electrolama/zoe/README.md

# zoe

A PoE powered Zigbee dev kit with RTC for Raspberry Pi.

Details at [electrolama.com/p/zoe](https://electrolama.com/projects/zoe).

zoe is designed by Electrolama / Omer Kilic and licensed under the [Solderpad Hardware License 2.0](https://solderpad.org/licenses/SHL-2.0/).
