electrolama/zoe/Revision C/pi-zigbee-poe-rtc.brd

## EAGLE design Revision C/pi-zigbee-poe-rtc.brd (2020-01-02)

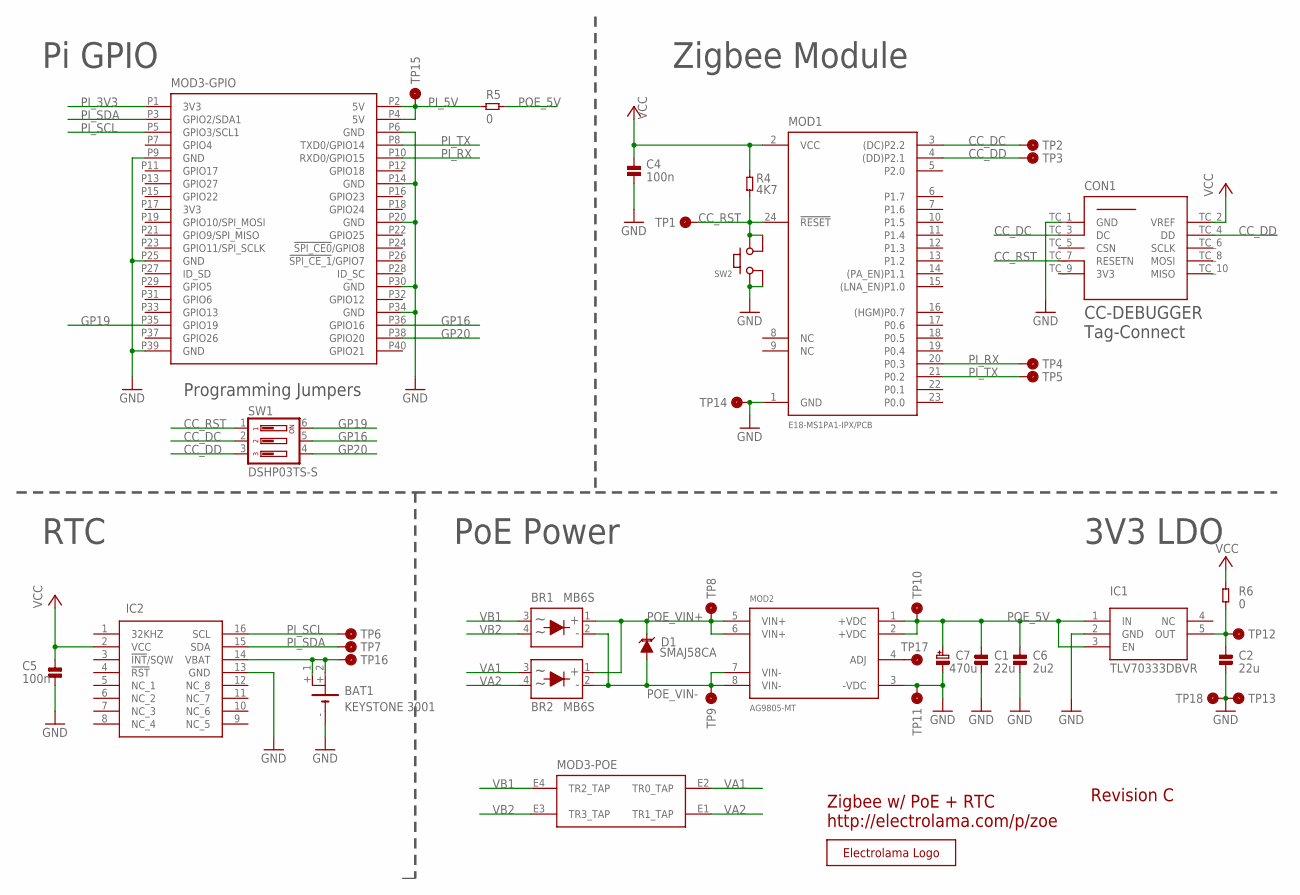
[picture p1: schematic pi-zigbee-poe-rtc.sch]

Parts:
BAT1: KEYSTONE 3001; KEYSTONE_3001
BR1, BR2: MB6S; SOP254P665X270-4N
C1, C2: 22u; _PKG_C_0805
C4, C5: 100n; _PKG_C_0603
C6: 2u2; _PKG_C_0603
C7: 470u; _CAP_ELCO_D8_L10.5
CON1: TC2050-IDC-NL_CC-DEBUGGER; TC2050-IDC-NL
D1: SMAJ58CA; DIOM5126X250N-NOPOL
IC1: TLV70333DBVR; SOT95P280X145-5N
IC2: RTC-DS3231SN#; SOIC127P1032X265-16N
MOD1: E18-MS1PA1-IPX/PCB; EBYTE-E18-MS1PA1
MOD2: AG9805-MT; SILVERTEL_AG9800M
MOD3: RPI-HAT-FULL
R4: 4K7; _PKG_C_0603
R5, R6: 0; TP_DUAL_1206
SW1: DSHP03TS-S
SW2: SPNO-XKB-TS-1187A; XKB-TS-1187A
TP1, TP2, TP3, TP4, TP5, TP6, TP7, TP8, TP9, TP10, TP11, TP12, TP13, TP14, TP15, TP16, TP17: TP; TP_DOT
TP18: TP-HOOK; TP_S2751-46R
U$1: LOGO-ELECTROLAMA; ELECTROLAMA

Connections:
CC_DC: CON1.TC_3 (DC), MOD1.3 ((DC)P2.2), SW1.2, TP2.TP
CC_DD: CON1.TC_4 (DD), MOD1.4 ((DD)P2.1), SW1.3, TP3.TP
CC_RST: CON1.TC_7 (RESETN), MOD1.24 (!RESET), R4.1, SW1.1, SW2.C (2_1), SW2.D (2_2), TP1.TP
GND: BAT1.-, C1.1, C2.1, C4.2, C5.2, C6.2, C7.-, CON1.TC_1 (GND), IC1.2 (GND), IC2.13 (GND), MOD1.1 (GND), MOD2.3 (-VDC), MOD3.P6 (GND), MOD3.P9 (GND), MOD3.P14 (GND), MOD3.P20 (GND), MOD3.P25 (GND), MOD3.P30 (GND), MOD3.P34 (GND), MOD3.P39 (GND), SW2.A (1_1), SW2.B (1_2), TP11.TP, TP13.TP, TP14.TP, TP18.1
GP16: MOD3.P36 (GPIO16), SW1.5
GP19: MOD3.P35 (GPIO19), SW1.6
GP20: MOD3.P38 (GPIO20), SW1.4
LDO_OUT: C2.2, IC1.5 (OUT), R6.1, TP12.TP
unnamed: BAT1.+_1 (+1), BAT1.+_2 (+2), IC2.14 (VBAT), TP16.TP
PI_3V3: MOD3.P1 (3V3)
PI_5V: MOD3.P2 (5V), MOD3.P4 (5V), R5.1, TP15.TP
PI_RX: MOD1.20 (P0.3), MOD3.P10 (RXD0/GPIO15), TP4.TP
PI_SCL: IC2.16 (SCL), MOD3.P5 (GPIO3/SCL1), TP6.TP
PI_SDA: IC2.15 (SDA), MOD3.P3 (GPIO2/SDA1), TP7.TP
PI_TX: MOD1.21 (P0.2), MOD3.P8 (TXD0/GPIO14), TP5.TP
POE_5V: C1.2, C6.1, C7.+, IC1.1 (IN), IC1.3 (EN), MOD2.1 (+VDC), MOD2.2 (+VDC), R5.2, TP10.TP
POE_ADJ: MOD2.4 (ADJ), TP17.TP
POE_VIN+: BR1.1 (+), BR2.1 (+), D1.1 (C), MOD2.5 (VIN+), MOD2.6 (VIN+), TP8.TP
POE_VIN-: BR1.2 (-), BR2.2 (-), D1.2 (A), MOD2.7 (VIN-), MOD2.8 (VIN-), TP9.TP
VA1: BR2.3, MOD3.E2 (TR0_TAP)
VA2: BR2.4, MOD3.E1 (TR1_TAP)
VB1: BR1.3, MOD3.E4 (TR2_TAP)
VB2: BR1.4, MOD3.E3 (TR3_TAP)
VCC: C4.1, C5.1, CON1.TC_2 (VREF), IC2.2 (VCC), MOD1.2 (VCC), R4.2, R6.2

Notes on the sheet:
RTC
Pi GPIO
Zigbee Module
PoE Power
3V3 LDO
Zigbee w/ PoE + RTC http://electrolama.com/p/zoe
Revision C
CC-DEBUGGER Tag-Connect
Programming Jumpers

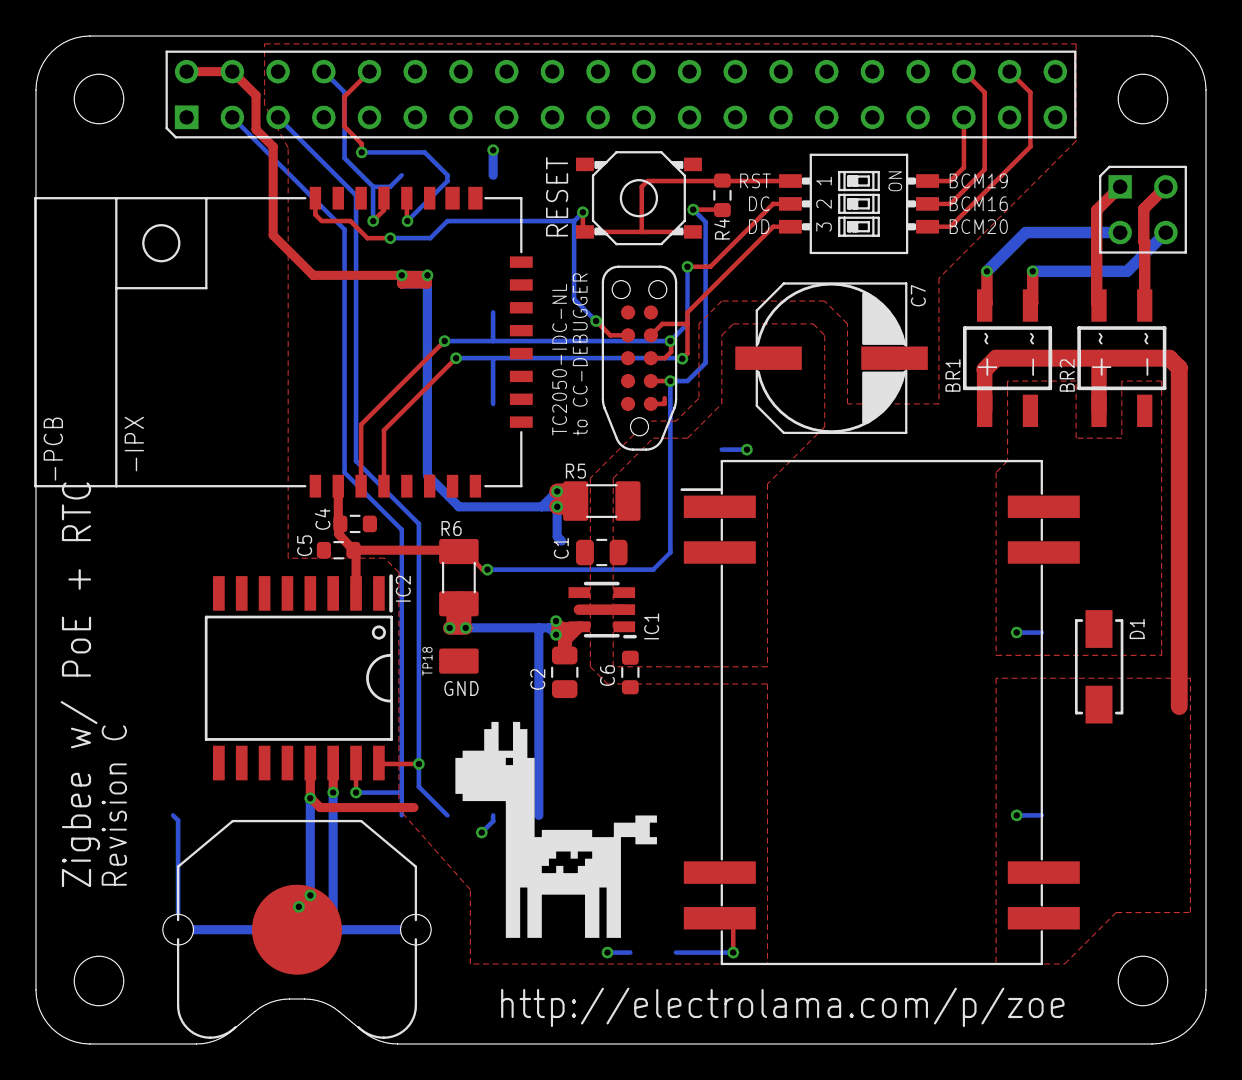
[picture p2: board pi-zigbee-poe-rtc.brd from above]

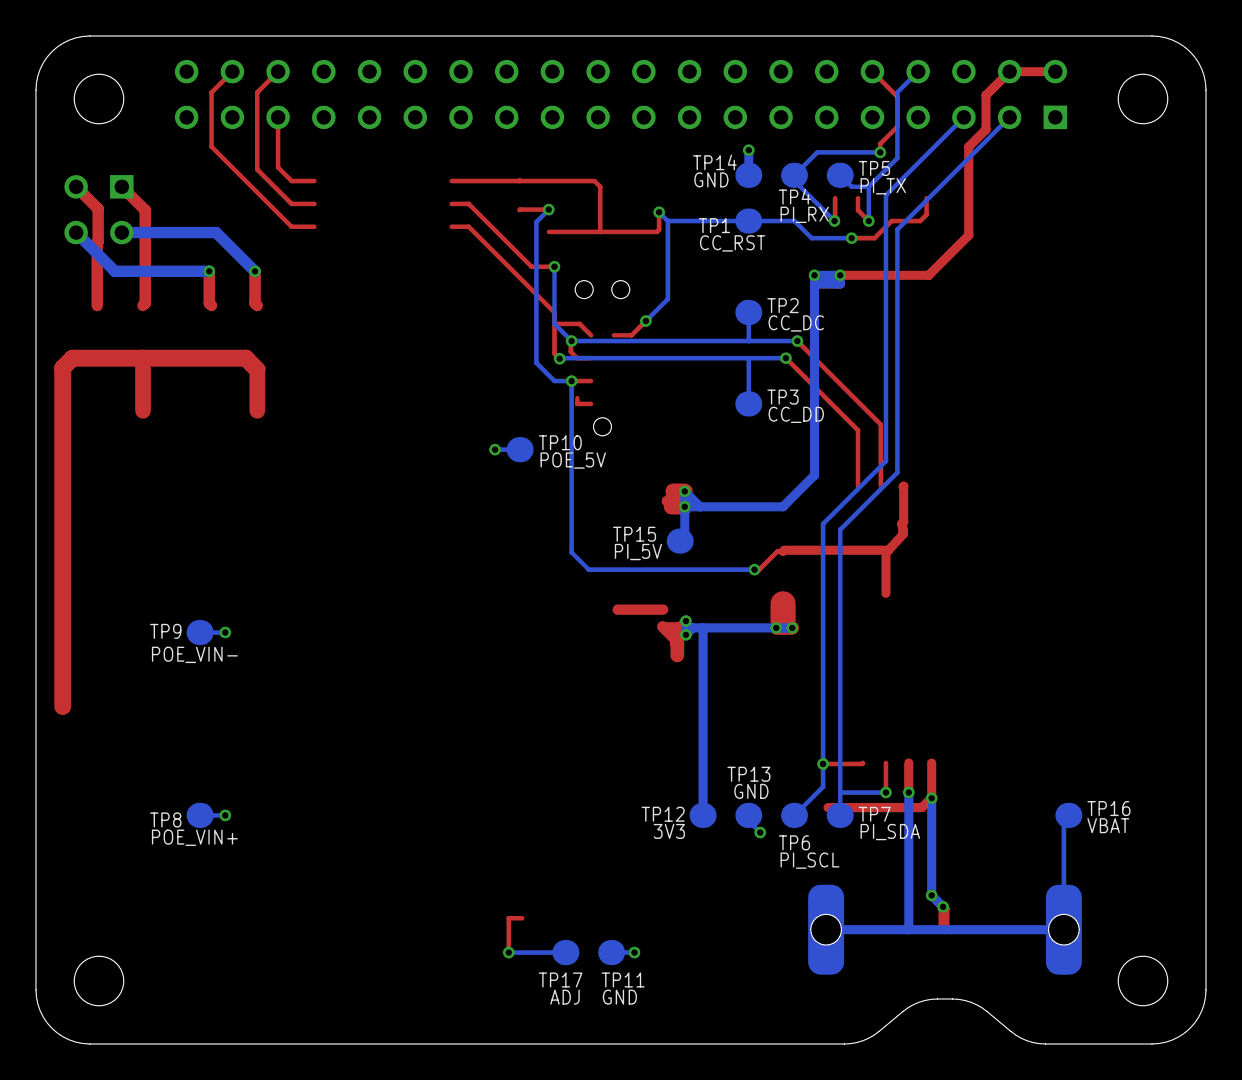
[picture p3: board pi-zigbee-poe-rtc.brd from below]

Board: 2 copper layers, 65.0 x 56.0 mm, 40 parts (17 on the bottom side), 23 nets.
