electrolama/zoe/(threads)

Thread 1 (2020-03-10):

CC2538 + CC2592 instead of CC2530 + CC2592 combo?

Gamester17, 2020-03-10:
@omerk have you considered using CC2538 instead of CC2530 on your zoe board?

CC2538 is more powerful and has more RAM so is capable of running Z-Stack 3.x for Zigbee 3.0

As a bonus, you could then run same version of Z-Stack 3 on zoe and zig-a-zig-ah!

See:
- https://github.com/Koenkk/zigbee2mqtt/issues/1568

and:
- https://github.com/Koenkk/Z-Stack-firmware/tree/master/coordinator

omerk, 2020-03-10:
Hey @Gamester17,

Similar discussion here: https://github.com/electrolama/zig-a-zig-ah/issues/4

I already have a mock-up of "zoe2" (better name suggestion?) and I will publish that once I am done with the current zoe and zzh revisions. CC2652 is the way to go, skipping CC2538.

Keep an eye on https://electrolama.com or [Subscribe to the mailing list](https://mailchi.mp/1746be86dd81/electrolama) to get updates when I publish more projects.

Closed 2020-03-10.

Thread 2 (2020-03-11):

[REQUEST] Add an antenna port on the zoe board for connecting external antenna to reduce interference and improve signal reception?

Hedda, 2020-03-11:
@omerk Have you considered adding an antenna port for connecting an external antenna to the zoe?

Not sure if a standard SMA (female) port would be a good choice on a HAT board as then not all Raspberry Pi enclosures would work without modification to the case, so can I suggest that you consider using a surface mounted Hirose U.FL a.k.a. "uFL" (female) port on the zoe board as they are already common on WiFi-adapters that have a Mini-PCIe/Mini-PCI/M.2 form-factor so there are plenty of inexpensive external 2.4GHz antennas an antenna-converters available for uFL ports?

https://en.wikipedia.org/wiki/Hirose_U.FL

The downside to the uFL (female) port is then one probably always has to uFL-female to SMA-female adapter in order to use an antenna with a SMA-male connection which is standard.

https://en.wikipedia.org/wiki/Hirose_U.FL#/media/File:2_mm_SMD_UFL_Socket.jpg

Bonus with an external antenna is that the Raspberry Pi internal WiFi should in theory not interfere as much the signals to and from the zoe HAT as if it would if it use an integrated antenna.

omerk, 2020-03-25:
Hey @Hedda, great suggestion!

The radio module I use on zoe comes in two flavours:

E18-MS1PA1-PCB:

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

and E18-MS1PA1-IPX:

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

Good news is that they are footprint compatible, -IPX is a little shorter than -PCB but that's only a minor cosmetic issue, so if you wanted to use an external antenna you could very easily do that without any design changes.

Moving the antenna away is theoretically a good move but I would still suggest strongly that you disable the WiFi and Bluetooth on the Pi as you will not be able to get far enough from it to make any real difference in term of RF interference. Also, as you have pointed out, finding a case to fit it all becomes an issue.

The ideal and intended use case for zoe is a Pi with wired Ethernet, it sits somewhere where you can pull an Ethernet cable to (and even use PoE to power it all if you don't want to deal with pulling power separately as well!) and the only radio working is the E18 module.

Hedda, 2020-03-26:
@omerk OK but that would make the external-antenna mandatory.

I was thinking that it would maybe be best with a design somehow and change the zoe board so that external-antenna could be made optional on the same board using the same radio module, however for that I guess it would need both integrated circuit board antenna as well as a uFL-port.

Ideas?

Perhaps as a  quick-and-dirty design-change workaround could be to use E18-MS1PA1-IPX but then also add a male uFL-port as well a integrated circuit board antenna to the zoe board and have a short male to female uFL antenna cable go-between the E18-MS1PA1-IPX radio module and the zoe board if you want to use the integrated circuit board antenna?

omerk, 2020-03-29:
The PCB trace antenna and the CC2592 range extender does a very good job without the need of an external antenna in my opinion and experience.

The key to a sensible Zigbee deployment is to have routers distributed around the house to form a good mesh network. Having the most powerful antenna on the coordinator is not going to magically fix all the range issues.

Given that there is already a workable solution in the form of an alternative module if you absolutely need an external antenna and the fact that the performance of the PCB antenna is satisfactory, I don't see the benefit of modifying the design.

Of course, this is an open-source hardware project and anyone is free to modify the design as they see fit. Keep in mind, the moment you add your own antenna on a PCB you then need to make sure it is matched and positioned correctly.

Closed 2020-03-25.

Thread 3 (2020-03-19):

Add connector for fan

bchris999, 2020-03-19:
RPi really needs a cooling fan (especially the 4). My current PoE adapter includes a built in fan, however it would be good to have a connector for a fan on this board. Would be difficult to connect one otherwise as the power (and possible speed control) pins are covered by this hat and therefore wouldn't be possible to connect one. Very excited for this to be available for purchase!

omerk, 2020-03-25:
Hey @bchris999, thanks for reaching out. Adding a header for a fan connection is certainly doable, I do wonder about the mechanical fit though as I can't really move the radio or the PoE modules all that much to create space for a fan to fit in. How do you envisage a fan being used when this addon is plugged in?

Raspberry Pi folks have done good work on reducing heat generated since the Pi 4 launched, have you updated your firmware recently? More here: https://www.raspberrypi.org/blog/thermal-testing-raspberry-pi-4/

I've never had issues on the setup that ran all my home automation up until last week (I switched everything over to a [zzh prototype](https://electrolama.com/projects/zig-a-zig-ah/)), a Pi4 with a zoe hat on and even when I did stress tests to see how well the PoE module would cope with hours of full (synthetic) load on a Pi4 it wouldn't crash. It got hot and there was thermal throttling but given that the intended use case for this addon is nowhere near the load of the synthethic load tests I am not too concerned about heat and the lack of a fan.

Interested in hearing your use case though, maybe you have a lot more running on the Pi you have?

bchris999, 2020-04-01:
Hi @omerk . Most cases I have seen have the fan built into the case, however I can't speak for how much space would be left for mechanical fit with the Zoe on board.
I haven't actually tried running my Pi without a fan (but with heat sinks), I will try that and report back my experience. My specific use case, as I would imagine a lot of peoples will be) is running Home Assistant, but the Pi also runs the addons for DuckDNS, Unifi controller, and a load of others too.
Currently I have a USB sticking out the side for Zigbee, so this project would make it into a nice integrated PoE powered box.

One other idea that may be useful is my current PoE hat has a cutout to expose the unused pins from the Pi's 40-pin header (it only drops onto the first 6 and the separate 4 block). Unfortunately it doesn't re-expose power pins for use, otherwise it would be ideal for development work too. Is this something that could be integrated into the Zoe? With this and re-exposed unused pins, a fan could be connected if desired using this.
(.e.g. https://quickbutik.imgix.net/7394y/products/5e024bcccd589.jpeg)

Thread 5 (2020-11-15):

Programming mode

emc02, 2020-11-15:
Hello, is the device working in programming mode too? Or do I have to put the Switches back to normal Mode after programming?
I am asking because I am working on an big project and would need to flash unattended.
Thanks!

omerk, 2021-01-22:
Hi @emc02, zoe design should be considered "retired" as it is based on older generation chips. zoe2, based on the newer CC1352P will be released soon, sign up to the [mailing list](https://electrolama.com/list) if you'd like to hear when it is released.

To answer your question, you will be able to program zoe2 "unattended" by bridging GPIO that controls the BSL trigger and RESET. I've also brought out the JTAG pins for OpenOCD but have not yet managed to get it working.

Closed 2021-01-22.
