electrolama/zoe/(commit log)

2020-01-02 add revision A files
    [pi-zigbee-poe-rtc.brd, pi-zigbee-poe-rtc.sch]
2020-01-02 add revision B files
    [pi-zigbee-poe-rtc.brd, pi-zigbee-poe-rtc.sch]
2020-01-02 add revision C files
    [pi-zigbee-poe-rtc.brd, pi-zigbee-poe-rtc.sch]
